JiaqiChen-Research/Chen-BCI-EEG/V1.0/hardware/documentation/3D_PCB1.png

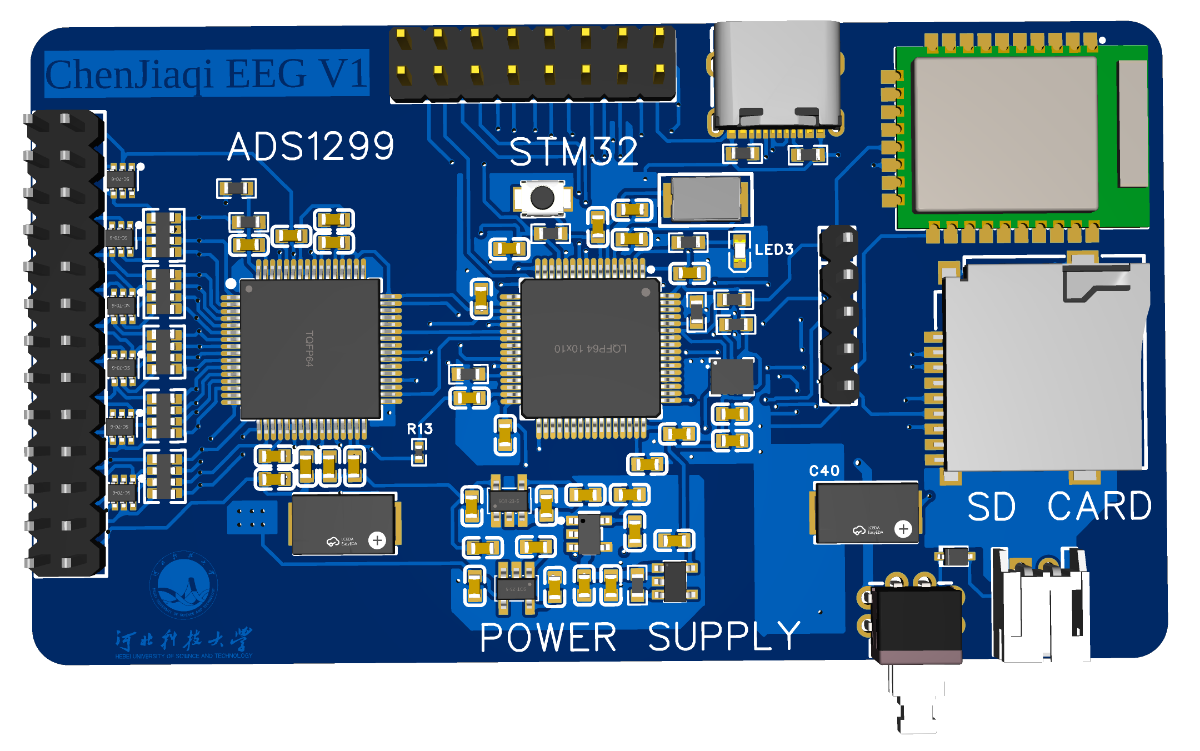
V1.0/hardware/documentation/3D_PCB1.png
