JiaqiChen-Research/Chen-BCI-EEG/V1.0/hardware/documentation/3D_PCB2.png

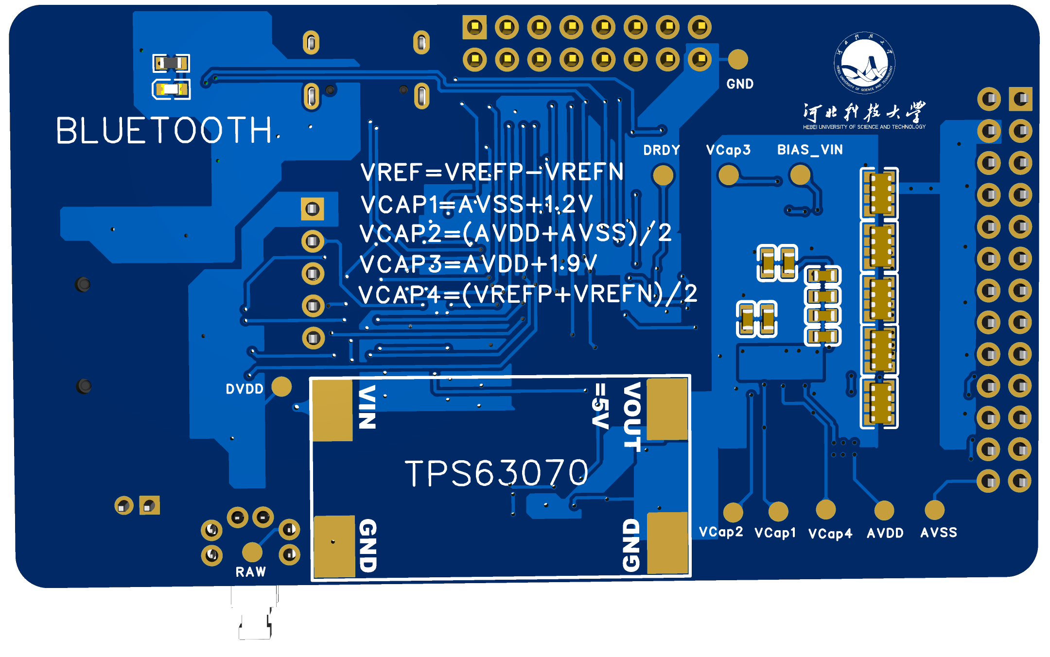
V1.0/hardware/documentation/3D_PCB2.png
