JiaqiChen-Research/Chen-BCI-EEG/V1.0/hardware/bom/BOM_Board1_PCB1_2026-08-22.xlsx

No. | Quantity | Comment | Designator | Footprint | Value | Manufacturer Part | Manufacturer | Supplier Part | Supplier
1 | 11 | Test-Point | AVDD,AVSS,BIAS_VIN,DVDD,GND,RAW,TP_DRDY,VCap1,VCap2,VCap3,VCap4 | Test-Point-0.5mm
2 | 2 | 100uF | C1,C40 | CAP-SMD_L7.3-W4.3-RD_177EC0013 | 100uF | TA10R0M100AR40 | JIERR(捷而瑞) | C49332976 | LCSC
3 | 4 | 1µF | C2,C3,C5,C6 | C0603 | 1µF
4 | 1 | 0.1µF | C4 | C0603 | 0.1µF
5 | 1 | 10uF | C7 | C0603 | 10uF
6 | 6 | 0.1uF | C8,C28,C30,C32,C34,C39 | C0603 | 0.1uF
7 | 5 | 1uF | C9,C27,C29,C31,C33 | C0603 | 1uF
8 | 1 | 1nF | C10 | C0603 | 1nF
9 | 1 | 0.01µF | C11 | C0603 | 0.01µF
10 | 6 | 2.2µF | C12,C14,C15,C17,C18,C19 | C0603 | 2.2µF
11 | 5 | 10µF | C13,C16,C20,C21,C22 | C0603 | 10µF
12 | 5 | 100nF | C23,C24,C25,C26,C49 | CAP-ARRAY-SMD_6124-8P-L1.6-W3.2-BL | 100nF | 6124B104K500NT | FH(风华) | C62857 | LCSC
13 | 2 | 2.2uF | C35,C36 | C0603 | 2.2uF
14 | 2 | 18pF | C37,C38 | C0603 | 18pF
15 | 7 | 100nF | C41,C42,C43,C44,C45,C46,C47 | C0603 | 100nF
16 | 1 | TF PUSH | CARD1 | TF-SMD_TF-PUSH |  | TF PUSH | SHOU HAN(首韩) | C393941 | LCSC
17 | 1 | B5819WS | D1 | SOD-323_L1.7-W1.3-LS2.5-FD |  | B5819WS | R+O(宏嘉诚) | C7420331 | LCSC
18 | 6 | TPD4E1B06DCKR | D2,D3,D4,D5,D6,D7 | SC-70-6_L2.2-W1.3-P0.65-LS2.1-BL |  | TPD4E1B06DCKR | TI(德州仪器) | C840093 | LCSC
19 | 1 | PZ254V-12-16P | H1 | HDR-TH_16P-P2.54-V-M-R2-C8-S2.54 |  | PZ254V-12-16P | XFCN(兴飞) | C492425 | LCSC
20 | 1 | PZ254V-11-05P | H2 | HDR-TH_5P-P2.54-V-M |  | PZ254V-11-05P | XFCN(兴飞) | C492404 | LCSC
21 | 2 | LTST-C190KSKT | LED2,LED3 | LED0603-RD |  | LTST-C190KSKT | LITEON(光宝) | C125095 | LCSC
22 | 1 | 0Ω | R1 | R0603 | 0Ω
23 | 1 | 1M | R2 | R0603 | 1M
24 | 4 | 10K | R3,R4,R5,R8 | R0603 | 10K
25 | 2 | 5.1K | R6,R7 | R0603 | 5.1K
26 | 2 | 4.7K | R9,R10 | R0603 | 4.7K
27 | 2 | 1K | R11,R12 | R0603 | 1K
28 | 1 | 0Ω | R13 | R0402 | 0Ω | 0402WGF0000TCE | UNI-ROYAL(厚声) | C17168 | LCSC
29 | 5 | 2kΩ | RN1,RN2,RN3,RN4,RN5 | RES-ARRAY-SMD_0603-8P-L3.2-W1.6-BL | 2kΩ | 4D03WGF2001T5E | UNI-ROYAL(厚声) | C270875 | LCSC
30 | 1 | XKB5858-Z-E | SW1 | SW-TH_XKB5858-Z-E |  | XKB5858-Z-E | XKB Connection(中国星坤) | C780038 | LCSC
31 | 1 | B3U-1000P | SW2 | KEY-SMD_B3U-1000PM |  | B3U-1000P | OMRON(欧姆龙) | C231329 | LCSC
32 | 1 | ADS1299IPAGR | U1 | TQFP-64_L10.0-W10.0-P0.50-LS12.0-TL |  | ADS1299IPAGR | TI(德州仪器) | C476817 | LCSC
33 | 1 | TPS72325DBVR | U2 | SOT-23-5_L3.0-W1.7-P0.95-LS2.8-BR |  | TPS72325DBVR | TI(德州仪器) | C69932 | LCSC
34 | 1 | TLV70025DDCR | U3 | SOT-23-5_L3.0-W1.7-P0.95-LS2.8-BR |  | TLV70025DDCR | TI(德州仪器) | C19619 | LCSC
35 | 1 | MCP1754T-3302E/OT | U4 | SOT-23-5_L2.9-W1.6-P0.95-LS2.9-BL |  | MCP1754T-3302E/OT | MICROCHIP(美国微芯) | C295712 | LCSC
36 | 1 | TPS60401QDBVRQ1 | U5 | SOT-23-5_L2.9-W1.6-P0.95-LS2.8-BR |  | TPS60401QDBVRQ1 | TI(德州仪器) | C2071133 | LCSC
37 | 1 | S2B-PH-K-S(LF)(SN) | U6 | CONN-TH_S2B-PH-K-S-LF-SN |  | S2B-PH-K-S(LF)(SN) | JST | C173752 | LCSC
38 | 1 | STM32F405RGT6 | U7 | LQFP-64_L10.0-W10.0-P0.50-LS12.0-BL |  | STM32F405RGT6 | ST(意法半导体) | C15742 | LCSC
39 | 1 | E73-2G4M08S1C | U8 | WIRELM-SMD_E73-2G4M08S1C |  | E73-2G4M08S1C | EBYTE(亿佰特) | C356849 | LCSC
40 | 1 | BMI270 | U9 | LGA-14_L3.0-W2.5-P0.50-BR |  | BMI270 | Bosch(博世) | C2836813 | LCSC
41 | 1 | DS1021-2x13SF11-B | U10 | HDR-TH_26P-P2.54-V-M-R2-C13-S2.54 |  | DS1021-2x13SF11-B | CONNFLY | C7430409 | LCSC
42 | 1 | TPS63070模块 | U19 | tps63070模块
43 | 1 | TYPE-C 16PIN 2MD(073) | USB1 | USB-C-SMD_TYPE-C-16PIN-2MD-073 |  | TYPE-C 16PIN 2MD(073) | SHOU HAN(首韩) | C2765186 | LCSC
44 | 1 | 8MHz | X4 | CRYSTAL-SMD_L5.0-W3.2 | 8MHz | X50328MSB2GI | YXC(扬兴晶振) | C115962 | LCSC
