JiaqiChen-Research/Chen-BCI-EEG/V1.0/hardware/documentation/SCH_Schematic1.pdf

# POWER SUPPLY

# INPUT PROTECTION

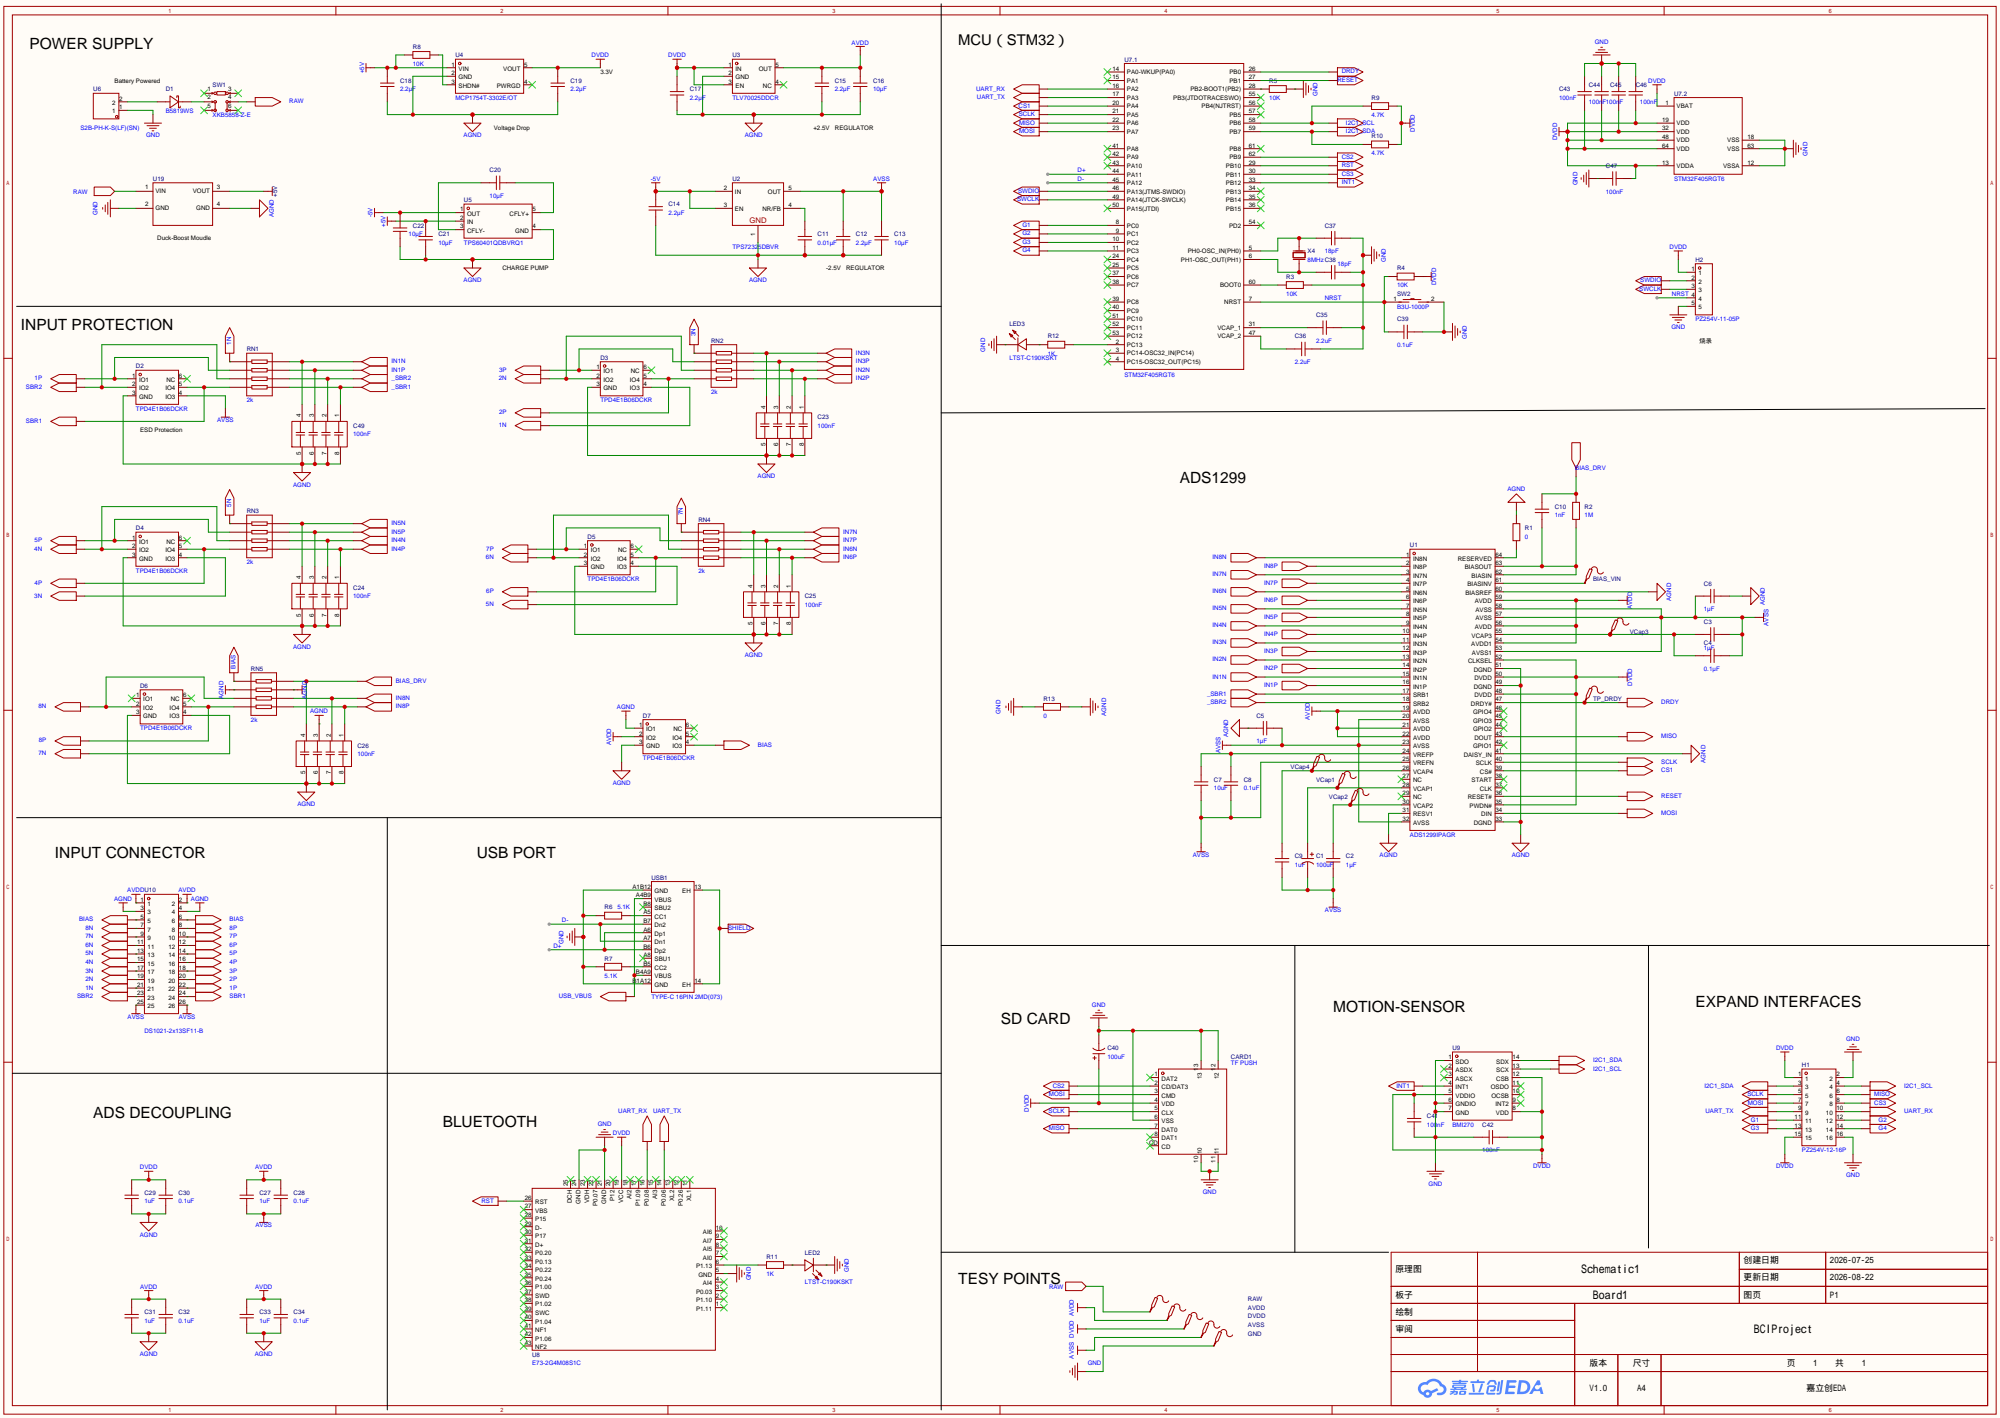
[picture p8: page 1]

AGND AGND AGND AVDD

XL1 11 P0.26 12 XL2 13 P0.06 14 AI3 15 P0.08 16 P1.09 17 AI2 18 VCC 19 P12 20 GND 21 P0.07 22 VDH 23 GND 24 DCH 25

原理图 | Schematic1 | 创建日期 | 2026-07-25

更新日期 | 2026-08-22

板子 | Board1 | 图页 | P1

绘制 | | BCIProject
审阅

V1.0 | A4 | 嘉立创EDA
