JiaqiChen-Research/Chen-BCI-EEG/V1.0/data_result/ECG/raw.csv

1E-3 | -1158861 | 1E-3 | -1827909.969
0.002 | -1167629 | 0.002 | -1767181.062
0.003 | -1180614 | 0.003 | -1708360.871
0.004 | -1199261 | 0.004 | -1652705.645
0.005 | -1219475 | 0.005 | -1601353.995
0.006 | -1224521 | 0.006 | -1555285.475
0.007 | -1228992 | 0.007 | -1515286.222
0.008 | -1237221 | 0.008 | -1481923.127
0.009 | -1245901 | 0.009 | -1455527.595
0.01 | -1249964 | 0.01 | -1436189.51
0.011 | -1249585 | 0.011 | -1423761.519
0.012 | -1244149 | 0.012 | -1417873.257
0.013 | -1234369 | 0.013 | -1417954.684
0.014 | -1216747 | 0.014 | -1423267.279
0.015 | -1198062 | 0.015 | -1432941.487
0.016 | -1192226 | 0.016 | -1446018.543
0.017 | -1186857 | 0.017 | -1461494.637
0.018 | -1177412 | 0.018 | -1478365.303
0.019 | -1169040 | 0.019 | -1495667.98
0.02 | -1164804 | 0.02 | -1512520.789
0.021 | -1164763 | 0.021 | -1528155.861
0.022 | -1172792 | 0.022 | -1541945.812
0.023 | -1183225 | 0.023 | -1553422.368
0.024 | -1201508 | 0.024 | -1562286.554
0.025 | -1223061 | 0.025 | -1568410.289
0.026 | -1230871 | 0.026 | -1571829.658
0.027 | -1236427 | 0.027 | -1572730.567
0.028 | -1243075 | 0.028 | -1571427.803
0.029 | -1249767 | 0.029 | -1568338.855
0.03 | -1254705 | 0.03 | -1563954.048
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
