JiaqiChen-Research/Chen-BCI-EEG/(commit log)

2026-08-22 Initial EEG hardware V1.0
    [BOM_Board1_PCB1_2026-08-22.xlsx]
2026-11-01 docs: update PCB section, add PCB top/bottom table, assembled photo
    [raw.csv]
2026-11-02 docs: update Graph1
    [BOM_Board1_PCB1_2026-08-22.xlsx, raw.csv]
